aaradhyakaushal5-source/CS-amplifier-simulation-and-layout/(commit log)

2026-07-25 Enhance README with simulation results and images
    Added detailed results and observations from the simulation, including settling time, phase inversion, and DC equilibrium. Updated schematic, simulation waveforms, and DRC/LVS check images.
2026-07-25 Update README with technology parameters and calculations
    Added technology parameters and calculations for nMOS and pMOS transistors, including threshold voltage, carrier mobility, oxide thickness, capacitance, and output resistance calculations.
